SolUtain/DOSeye/README.md

# DOSeye
Boston University ECE Senior Design Team 3

Mike Ethier, Solomon Utain, Ami Vyas, Alex Wang
