SolUtain/DOSeye/Hardware Readme.pdf

The first thing needed for this project is a PCB design program so that the hardware can be made. Altium is already installed on the computers in the Senior Design Lab but we used ExpressPCB which is a free software that can be installed from: https://www.expresspcb.com/free-cad-software/

VCSEL Schematic:

There are several different VCSEL PCB designs. All of them have four RF inputs which use MMX connectors. These four inputs connect to four of the pins on the VCSEL, these separate inputs are used for the four different wavelengths. The top pin of the VCSEL is just connected to ground.

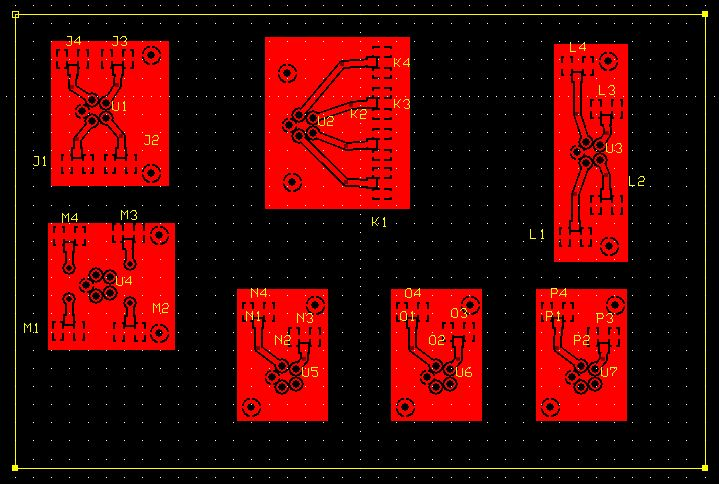
[picture p16: figure]

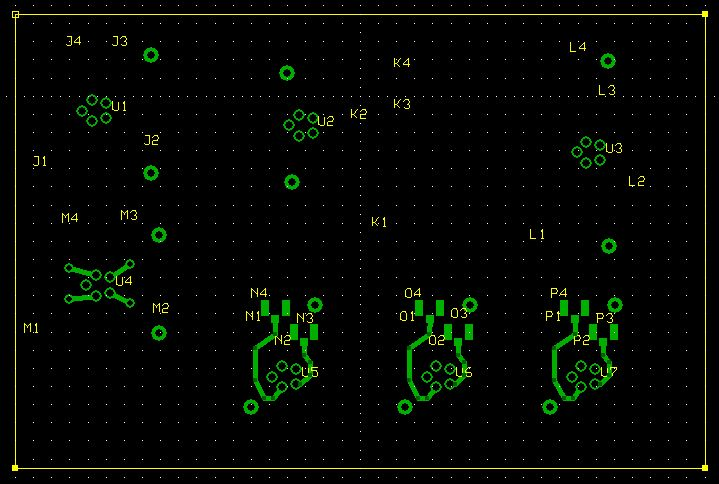
[picture p17: figure]

APD Schematic:

The PCB design software ExpressPCB was used to design the board. Factors such as simplicity, ease of use, depth of the individual parts (to keep the APD flush with the surface), soldering ability, and size were considered in the design process. In addition, we tried to take into account the characteristic impedance of the traces themselves, and thus made the traces for the high voltage connection and the RF outputs much larger. The traces for the outputs are approximately 120 mils wide to match the SMA connectors’ impedance of 50 ohms. Once the board arrived, we soldered the parts on by hand, with the exception of the APD itself. For the APD, we had the EDF solder it on for us, due to its incredibly small contact points.

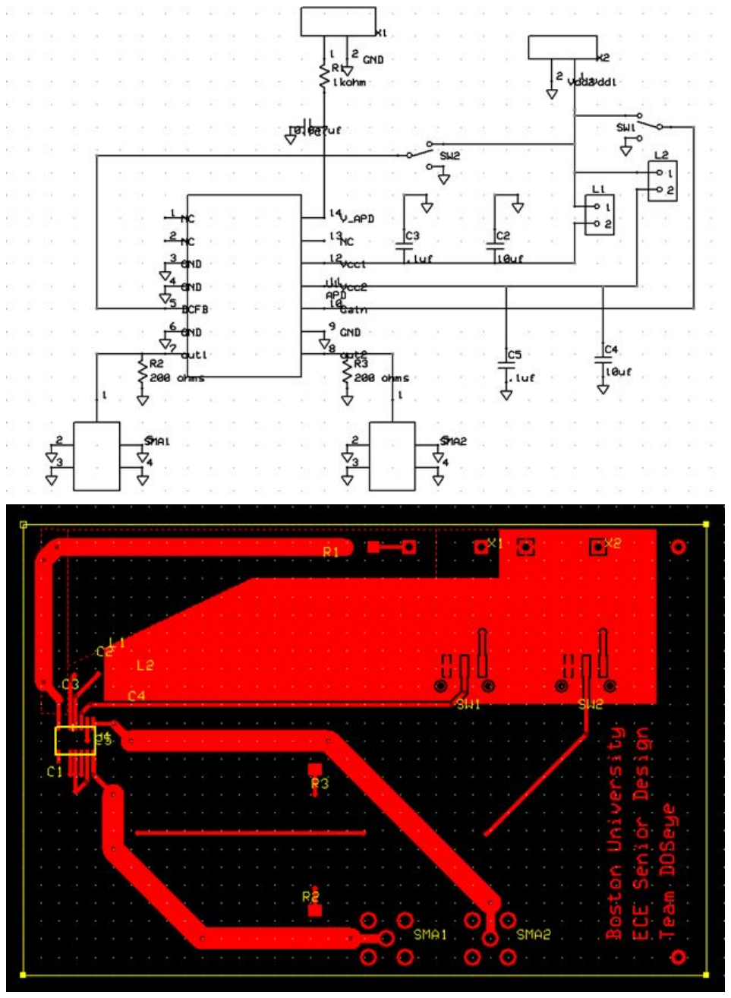
[picture p18: page 3]

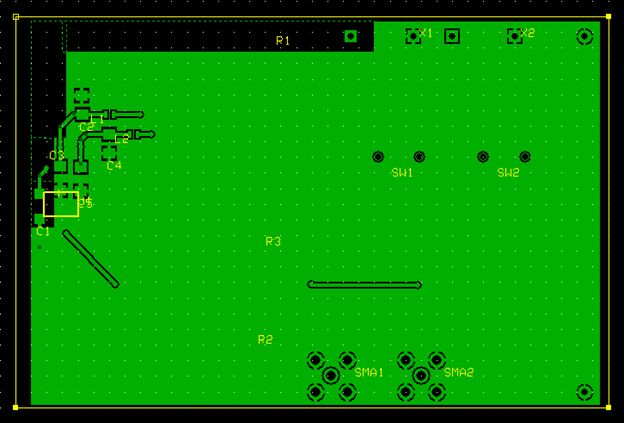
[picture p19: figure]

Voltage Converter Schematic:

Referring to the diagram below for the high voltage converter PCB, input pin 5 should be connected to the 12V DC output from the AC to DC converter. Input Pins 4 and 7 should be connected to the output of the 5V DC to DC converter. Input Pins 3, 6, and 8 should all be connected together, while Input Pins 1 and 2 should be grounded. Additionally, the inputs for both the 3.3V DC to DC converter and the 5 V DC to DC converter should be connected to the 12V output of the AC to DC converter. Finally, the output of the 3.3V DC to DC converter should be connected to the low voltage input of the APD PCB.

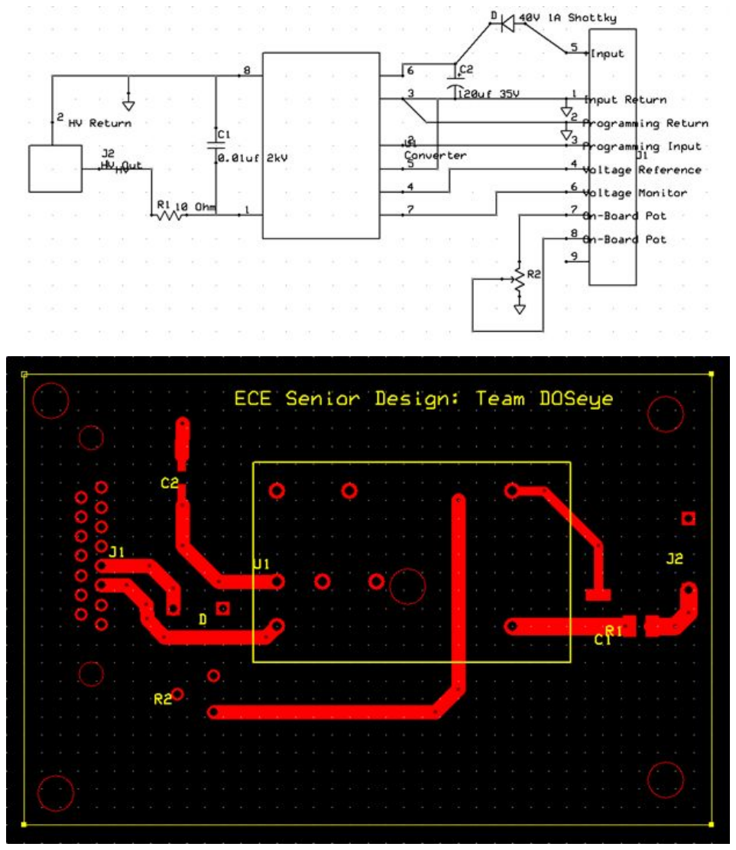
[picture p20: page 5]
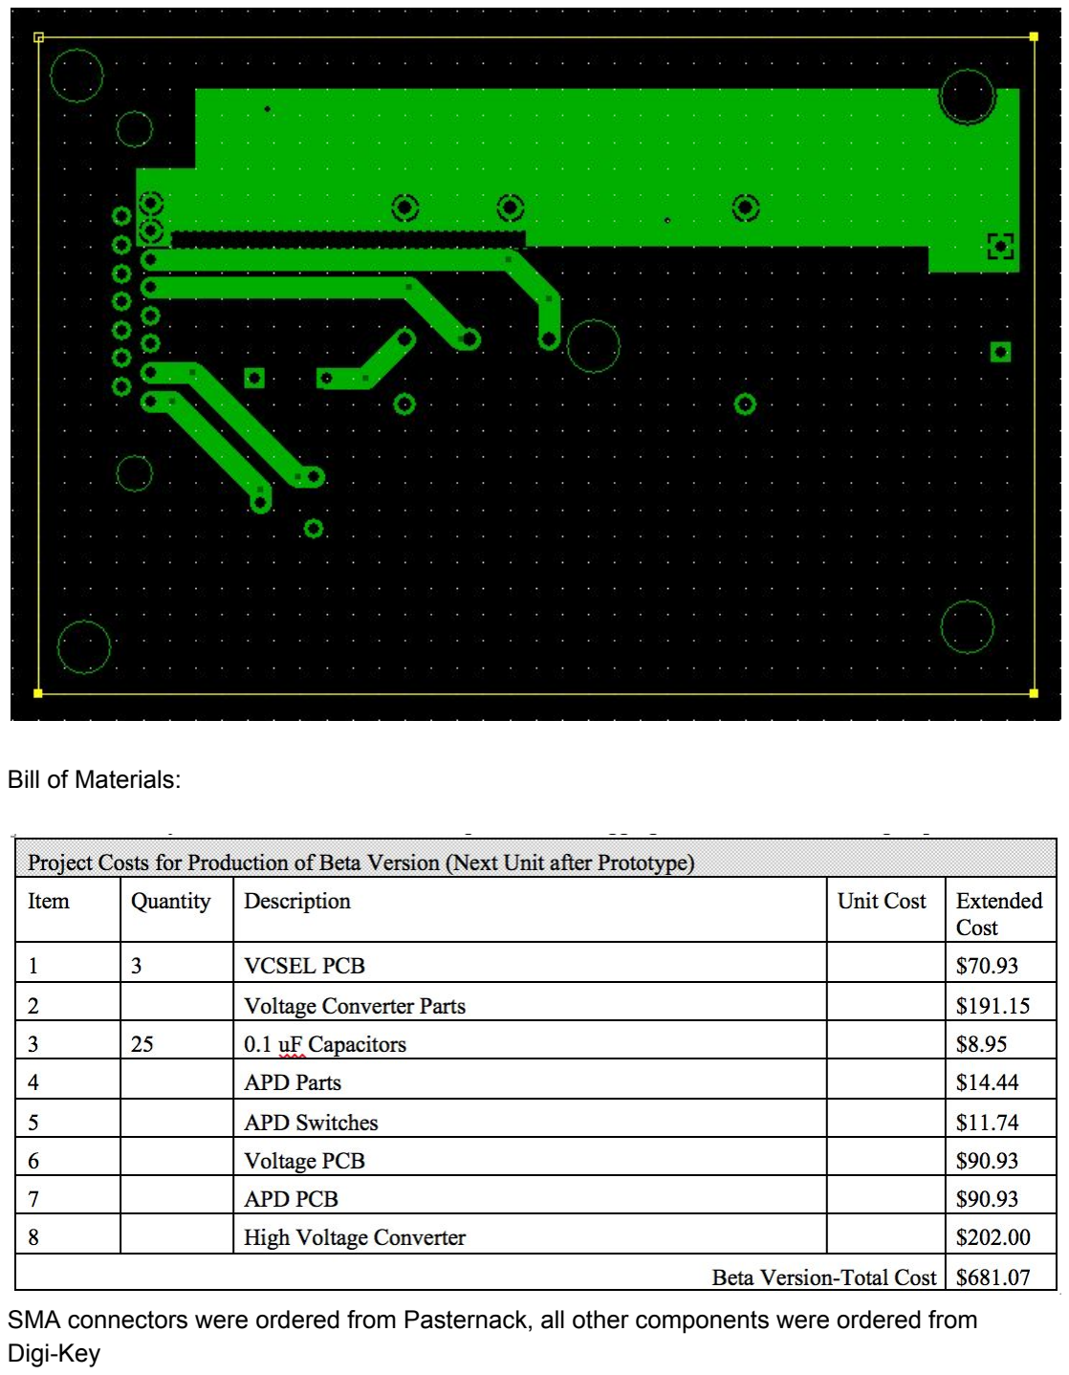
[picture p21: page 6]

Bill of Materials:

SMA connectors were ordered from Pasternack, all other components were ordered from Digi-Key

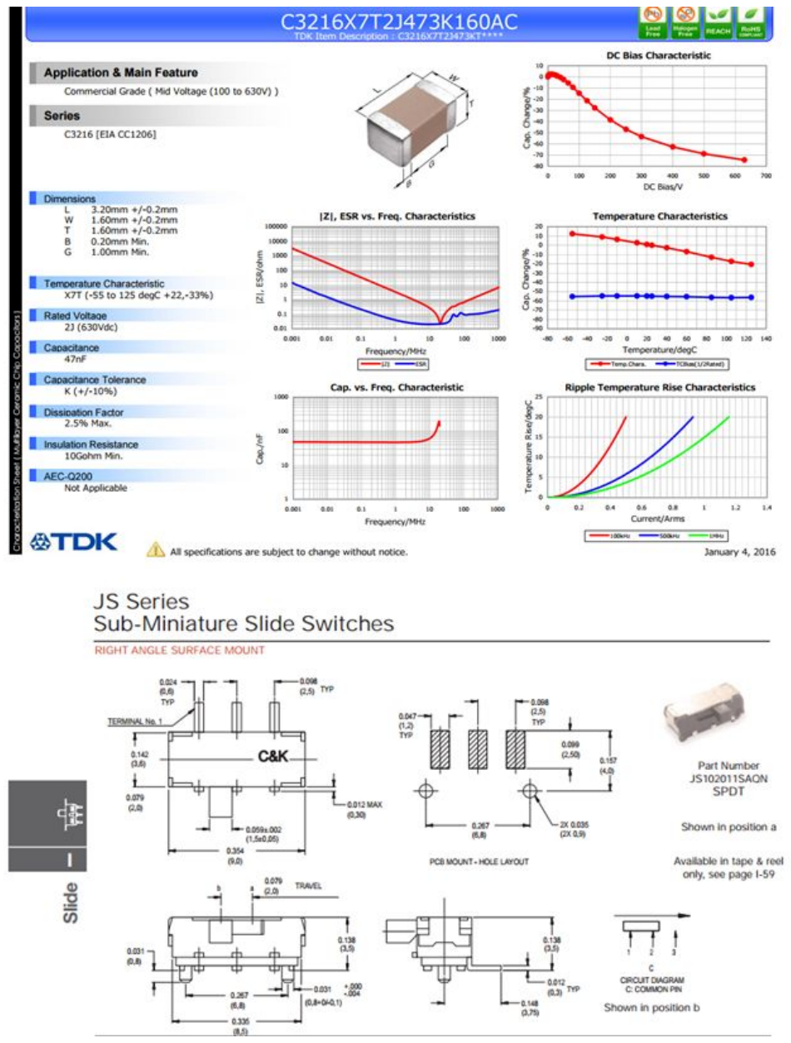
[picture p22: page 7]

Components used for APD PCB:
200 ohm resistors (used 1206 size, digikey #541-200ECT-ND) BLM18PG221SN1D Ferrite Bead
1kOhm Resistor, used size 1206, digikey #311-1.00KFRCT-ND 10uF capacitor, used 1206 size, digikey #311-1376-1-ND 0.1uF capacitor, used 1206 size, digikey #399-1249-1-ND

Components used for High Voltage PCB:
10 ohm resistor digi-key #P16861CT-ND
1N5819 Schottky Diode
1kOhm Potentiometer, digikey part #3310Y-001-103L-ND 120uF electrolytic capacitor, digikey #P18961CT-ND 10000pF capacitor, used size 1812, digikey #399-10477-1-ND

Power Requirements:

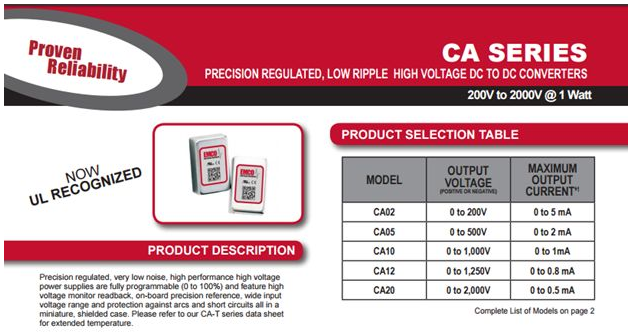
[picture p23: figure]

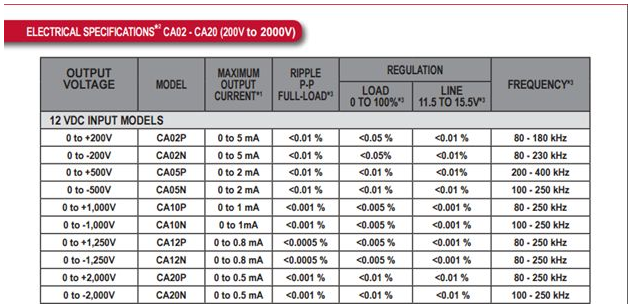
[picture p24: figure]
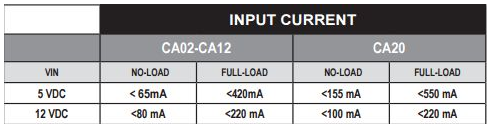
[picture p25: figure]

(used model CA02 with the 12VDC input)

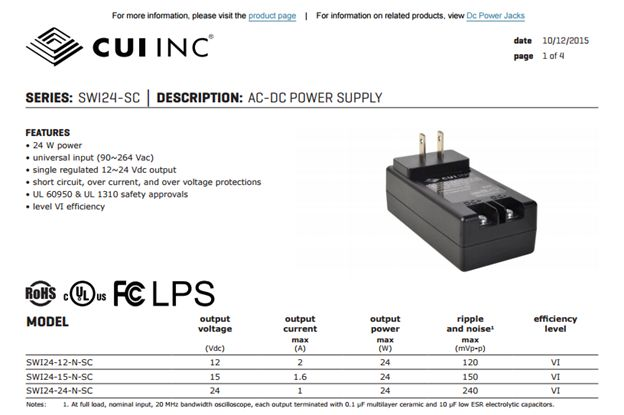
[picture p26: figure]

(Used model SWI24-12-N-SC)

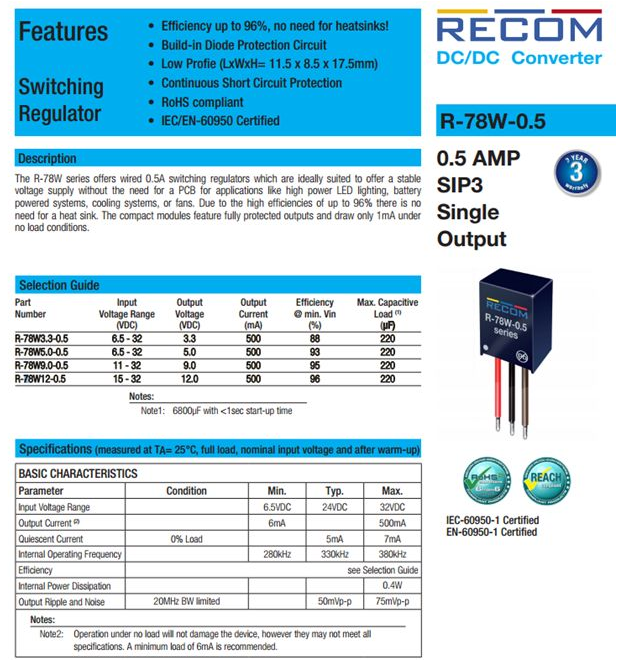
[picture p27: figure]

(Used one converter with an output of 3.3V for the low-voltage supply and a 5V output converter for a reference voltage for the high-voltage converter)

The APD circuit board can be plugged into a standard wall outlet for power via the voltage converters and wall adapter. The VCSEL circuit board must be connected to the RF switch and the current controller in the lab.

Power Sequence
Plug the Voltage Converter into a wall outlet and flip the switch to turn on the power. For the VCSEL power, it must be connected to the RF switch and the current controller in the lab.

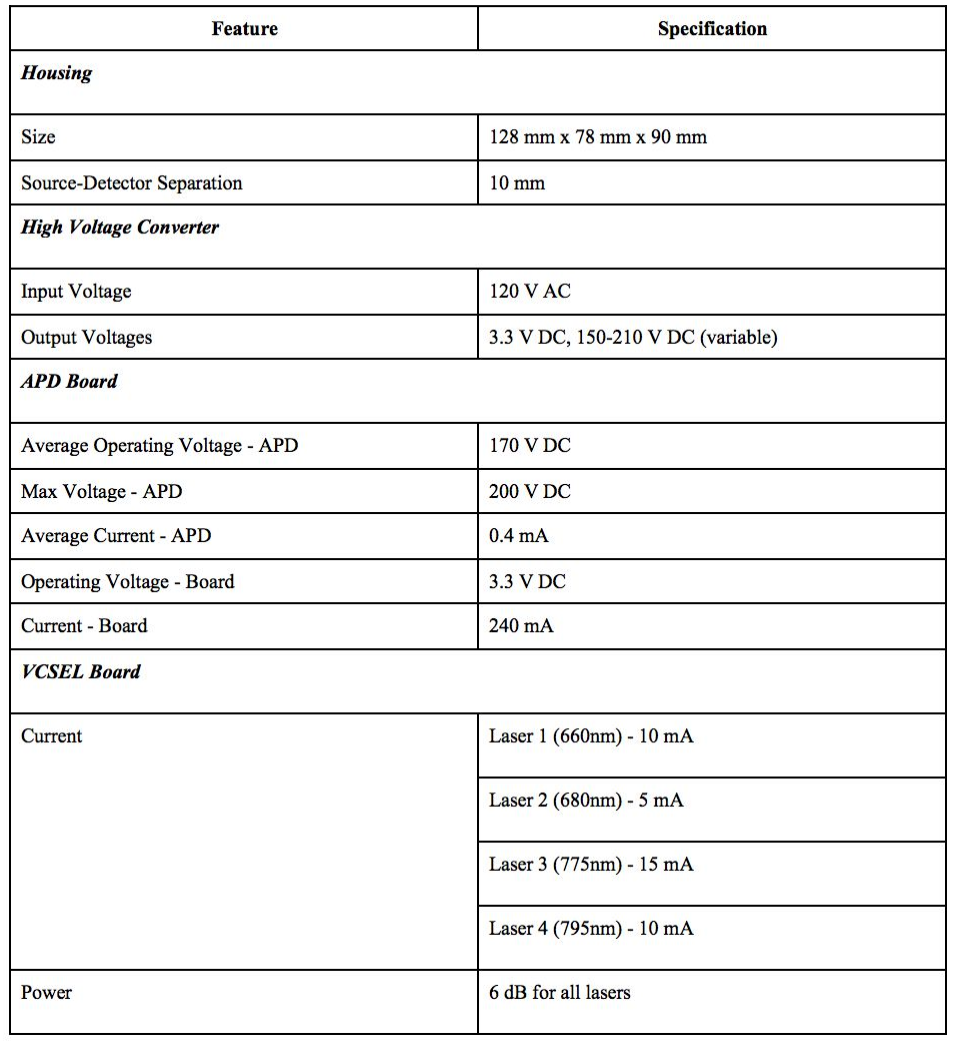
[picture p28: figure]

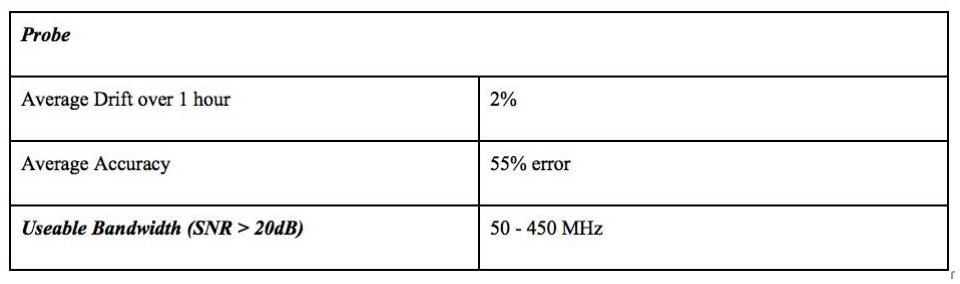
[picture p29: figure]
