SolUtain/DOSeye/Design Files/MMX_VCSEL.SLDPRT

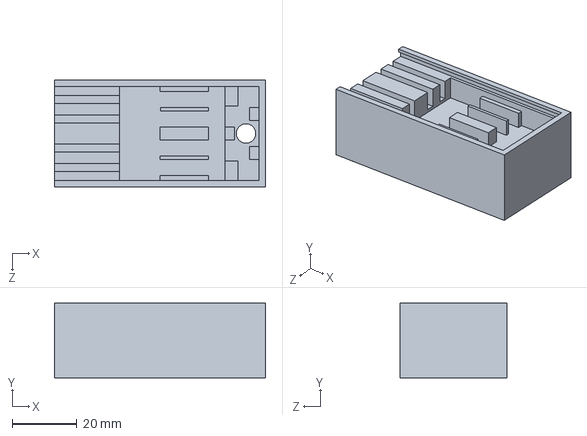
[picture p30: CAD file, 2017-05-01]
Design Files/MMX_VCSEL.SLDPRT
65.0 x 23.0 x 33.0 mm
