SolUtain/DOSeye/Design Files/Probe_Shielding.SLDPRT

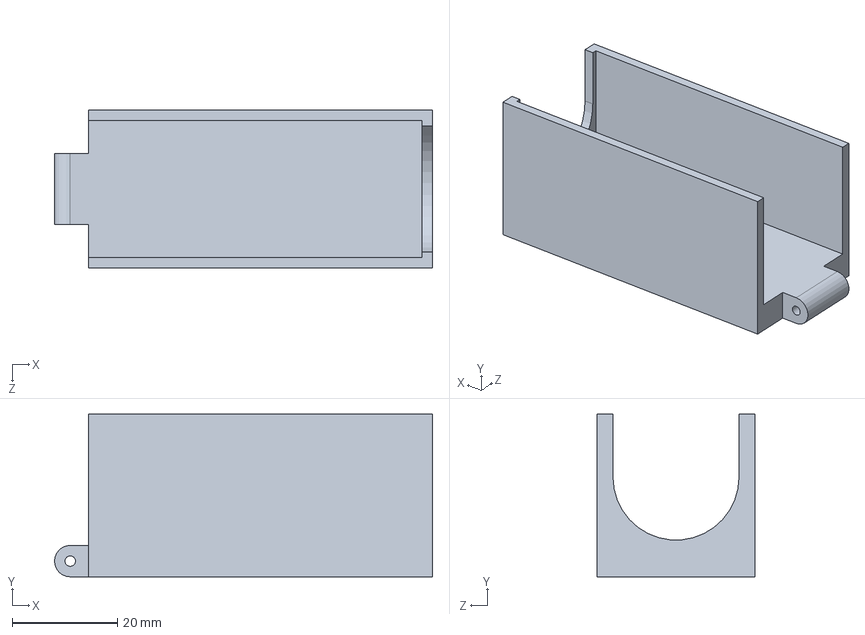
[picture p31: CAD file, 2017-05-01]
Design Files/Probe_Shielding.SLDPRT
72.0 x 31.0 x 30.0 mm
