SolUtain/DOSeye/Design Files/Final_Probe.SLDPRT

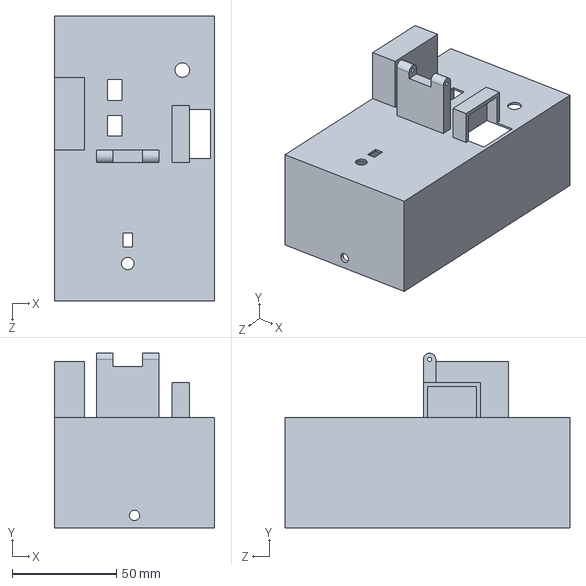
[picture p32: CAD file, 2017-05-01]
Design Files/Final_Probe.SLDPRT
77.0 x 84.0 x 137.0 mm
