SolUtain/DOSeye/Design Files/ProbeBottom.SLDPRT

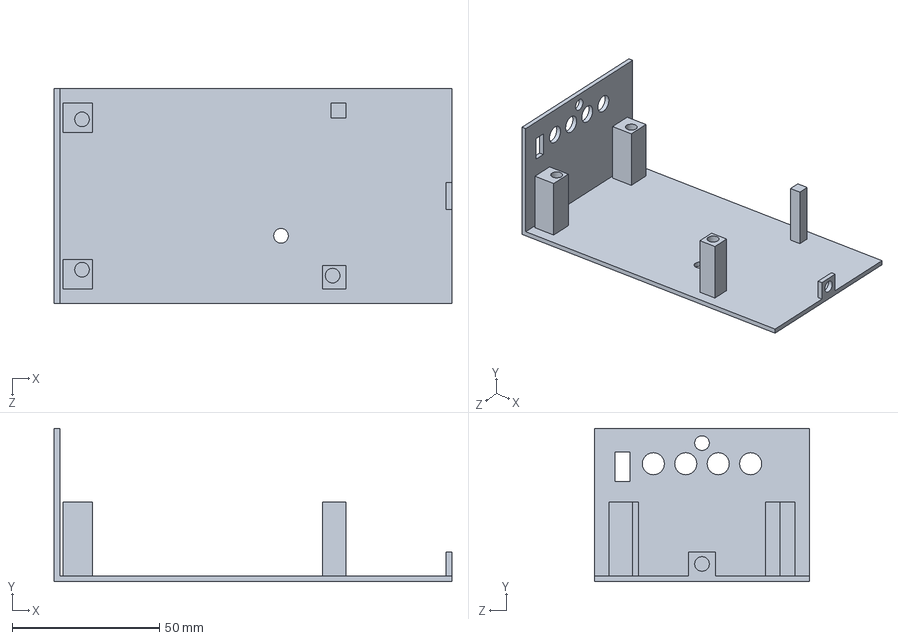
[picture p33: CAD file, 2017-05-01]
Design Files/ProbeBottom.SLDPRT
135.0 x 52.0 x 73.0 mm
