SolUtain/DOSeye/(list of files, cad)

Other CAD files:
Design Files/Final_Probe.STL
Design Files/MMX_VCSEL.STL
Design Files/ProbeBottom.STL
Design Files/Probe_Shielding.STL
