SolUtain/DOSeye/Design Files/Final_Probe.PDF

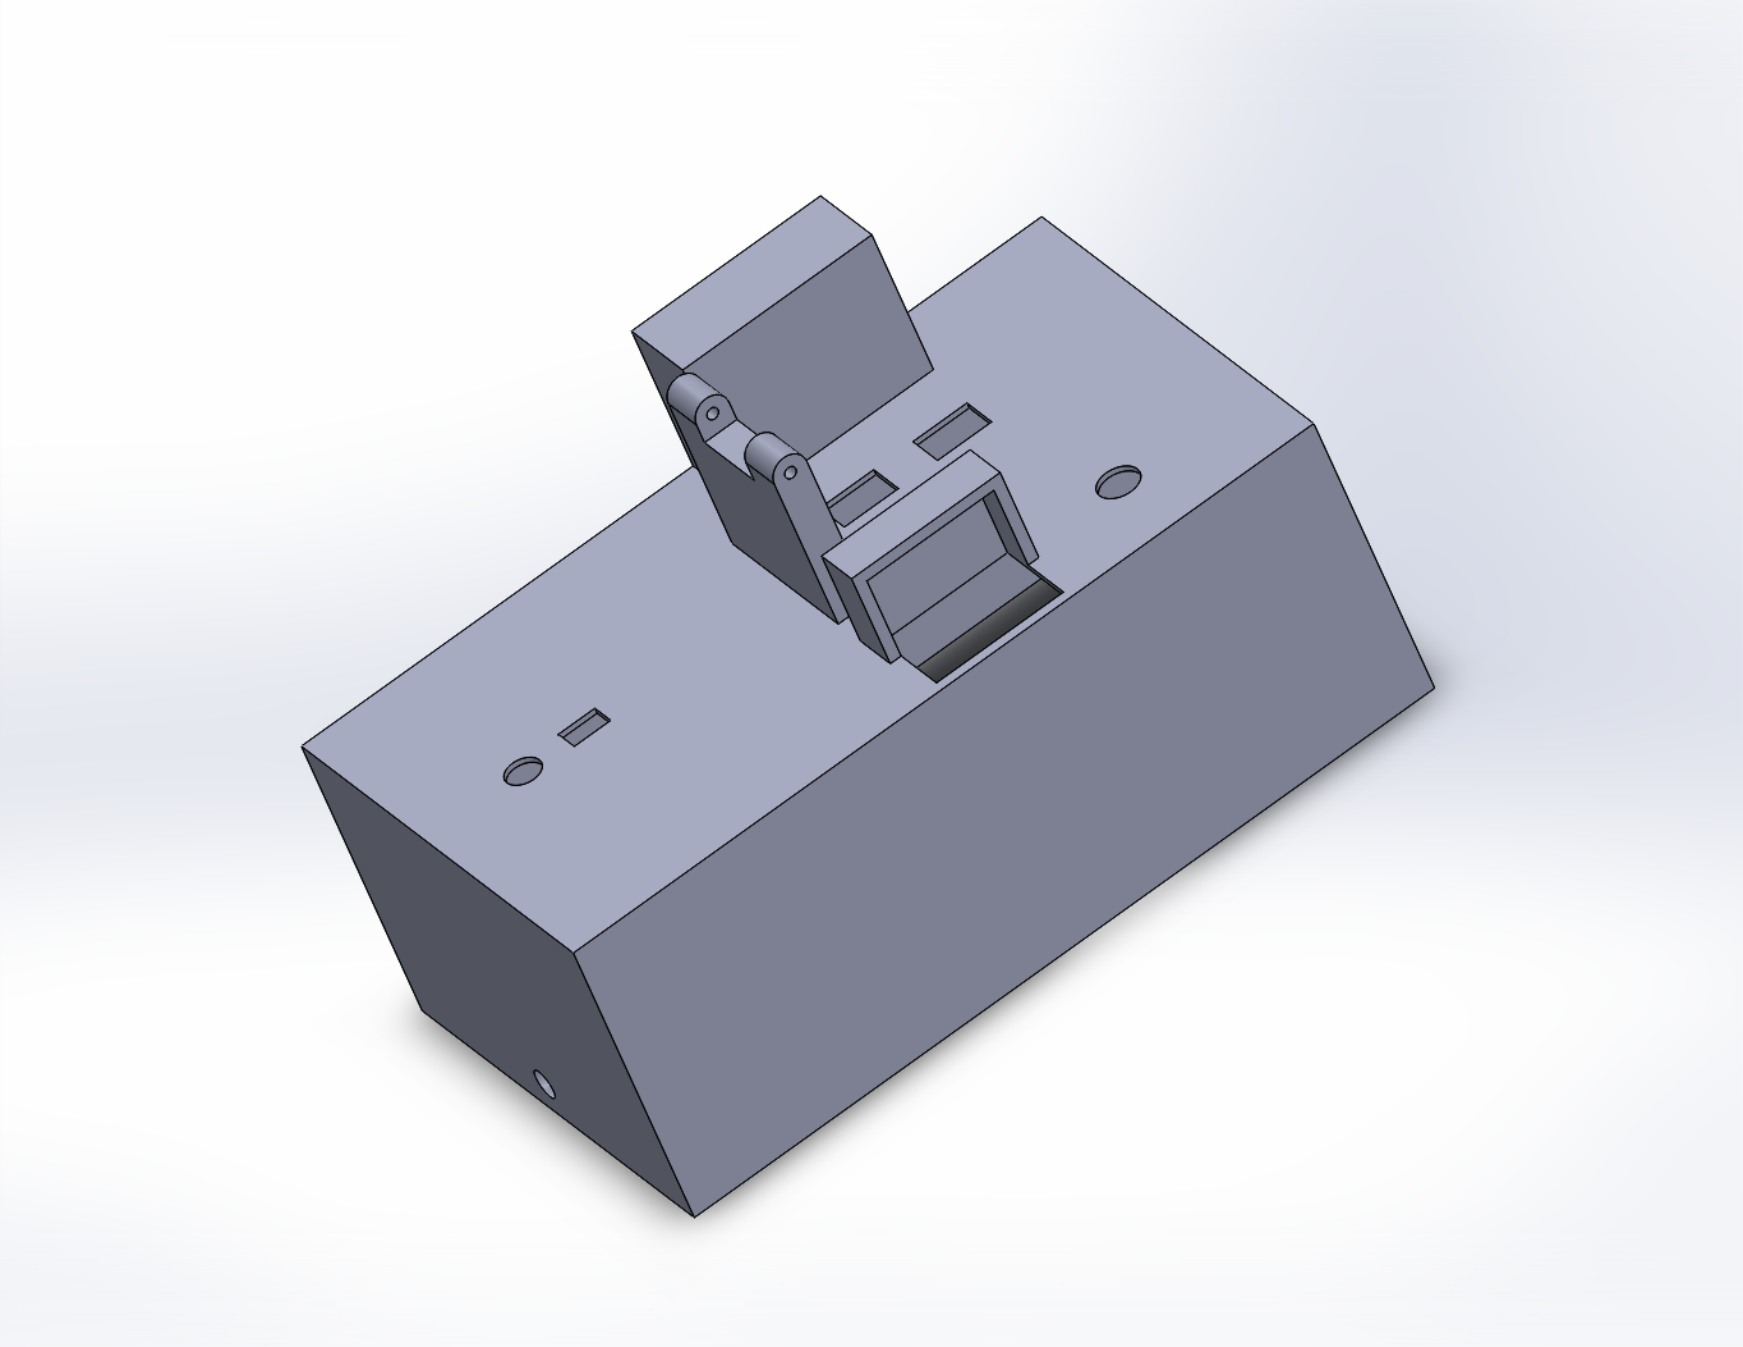
[picture p63: page 1]
