SolUtain/DOSeye/Design Files/Probe_Shielding.PDF

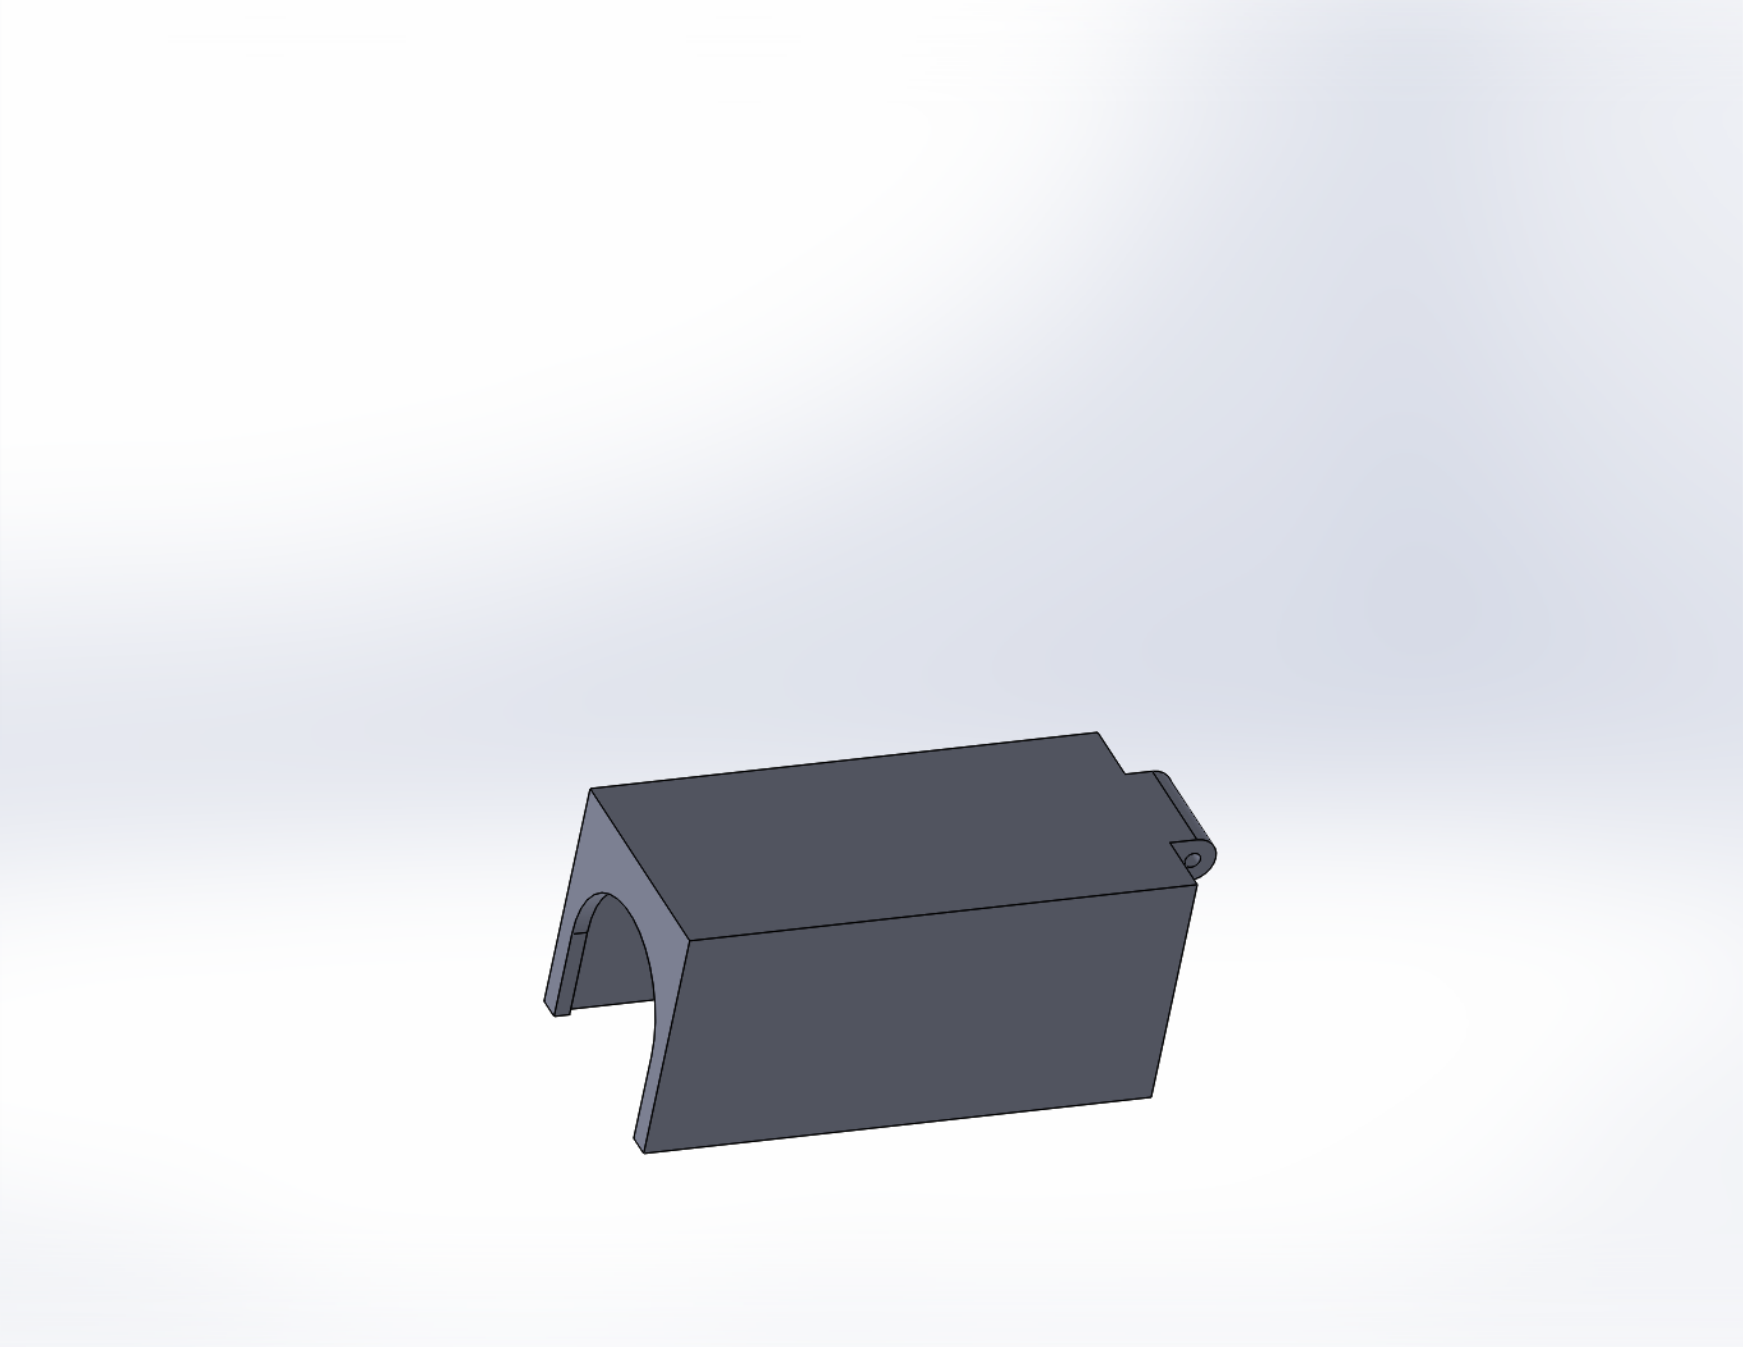
[picture p64: page 1]
