SolUtain/DOSeye/Design Files/ProbeBottom.PDF

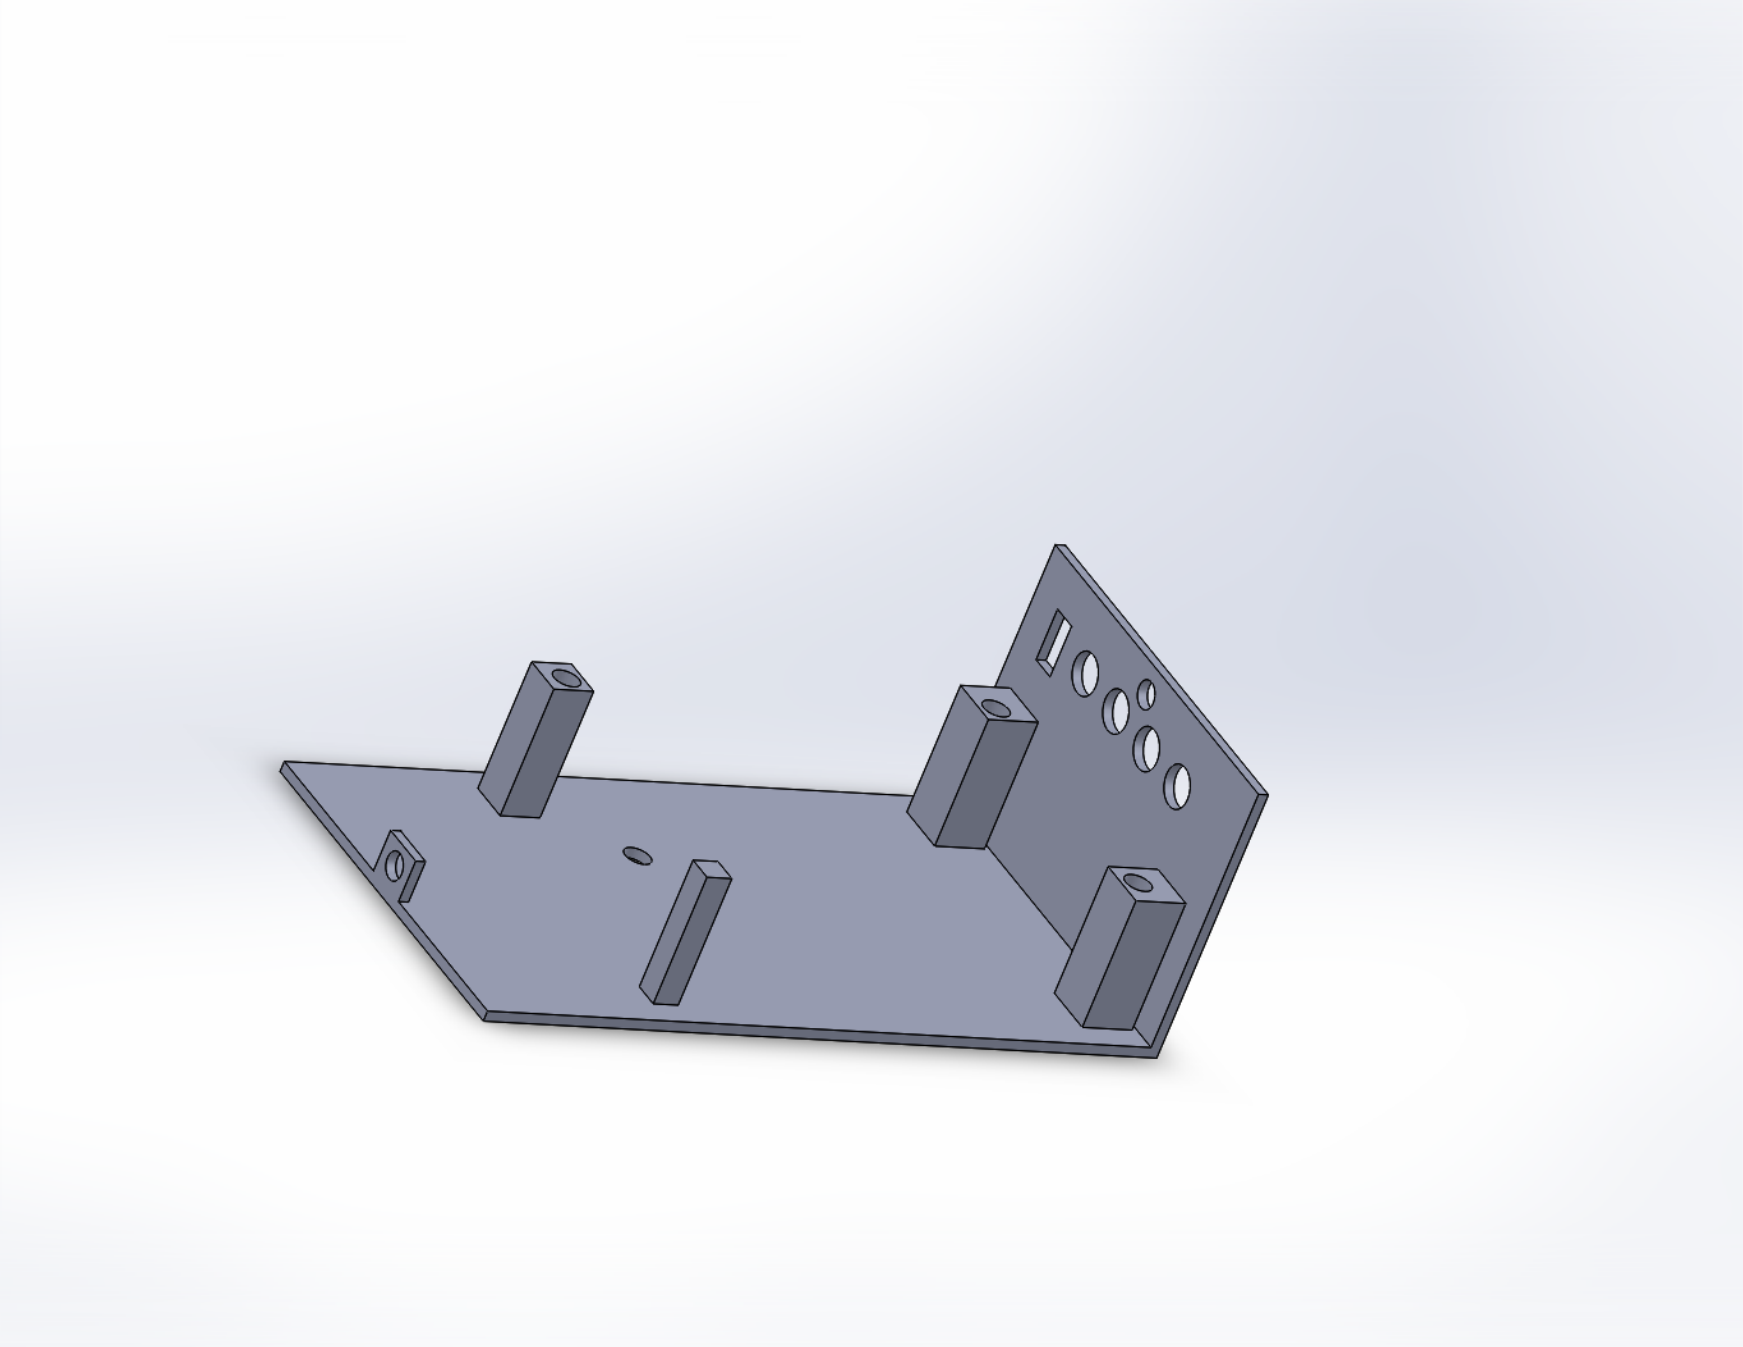
[picture p65: page 1]
