SolUtain/DOSeye/(list of files, drawings)

Other design files:
Design Files/4Wave_VCSEL_SMA_breakout.pcb
Design Files/APD PCB Ver 2.pcb
Design Files/APD PCB.pcb
Design Files/High Voltage Converter PCB.pcb
